SubikshaJ/GroundLoopIssue/Techathon Presentation.pptx

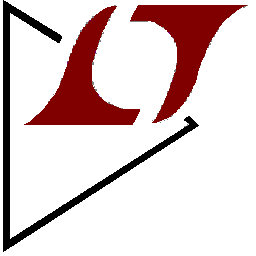
[picture p1: figure]
LTspice Download for Windows 11 PC. 64 bit

IEEE Techathon
Frequency Gate

Team: Ground Loop Issue
Noah Schunck
Subi Jayakumar
Mihir Chaudhari

## Slide 2

Problem

Audio effect pedals can make music sound better, but their frequency response is not ideal

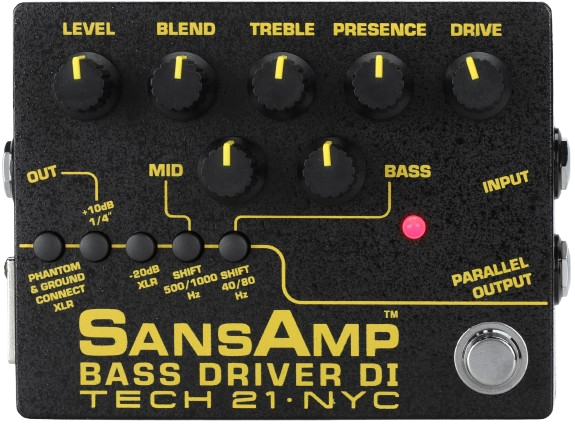
[picture p2: figure]

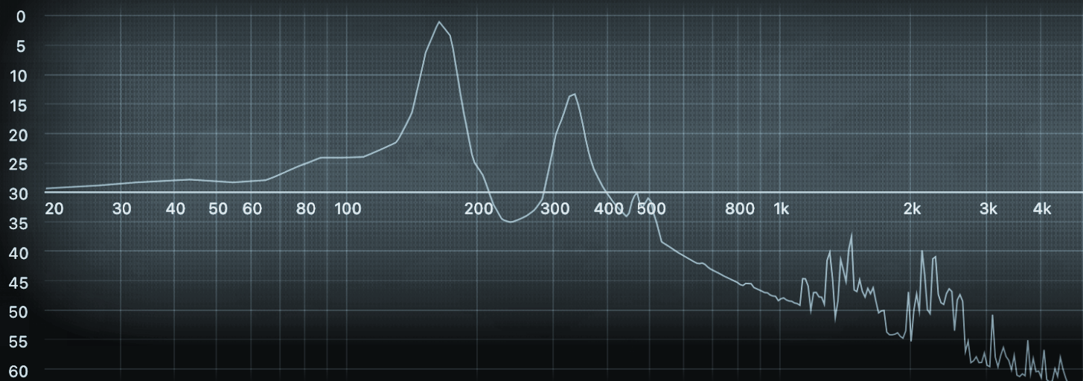
[picture p3: figure]

Frequency (Hz)

Unwanted frequency

## Slide 3

Non-ideal Frequency Response

E1 (Low note) + Effect

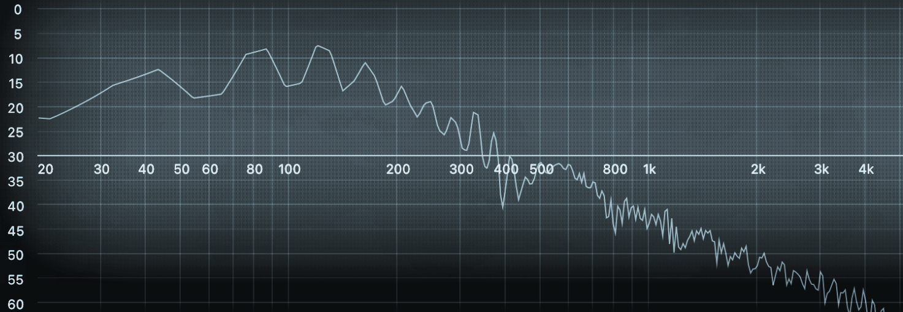
[picture p4: figure]

E3 (High note) + Effect

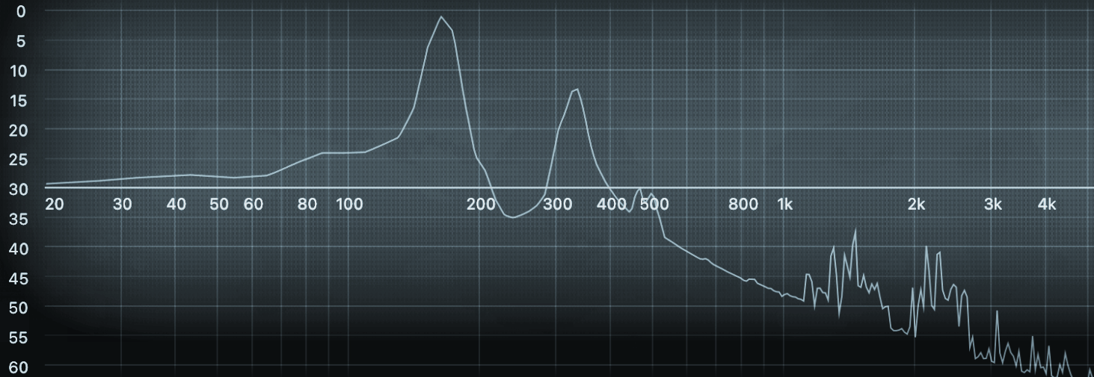
[picture p5: figure]

High frequency peaking, bad

Good

E1 (Low note) + No effect

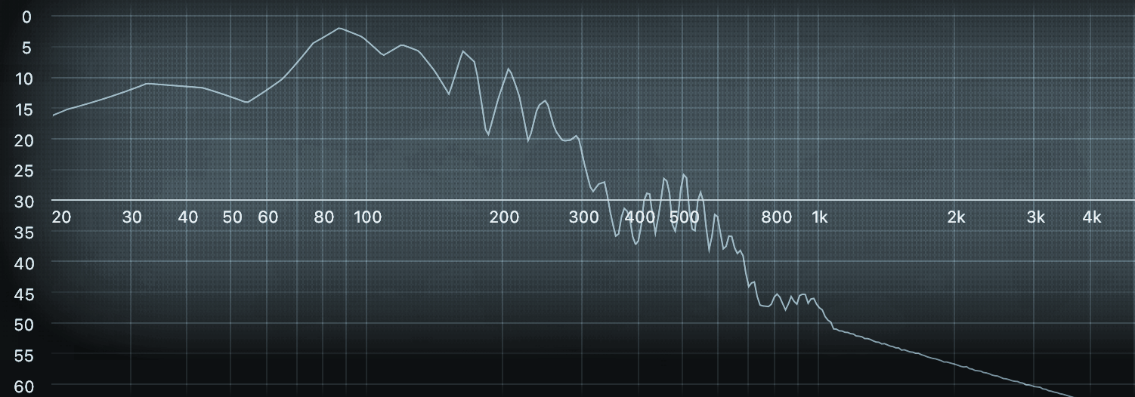
[picture p6: figure]

Lacks high frequency effects

E3 (High note) + No effect

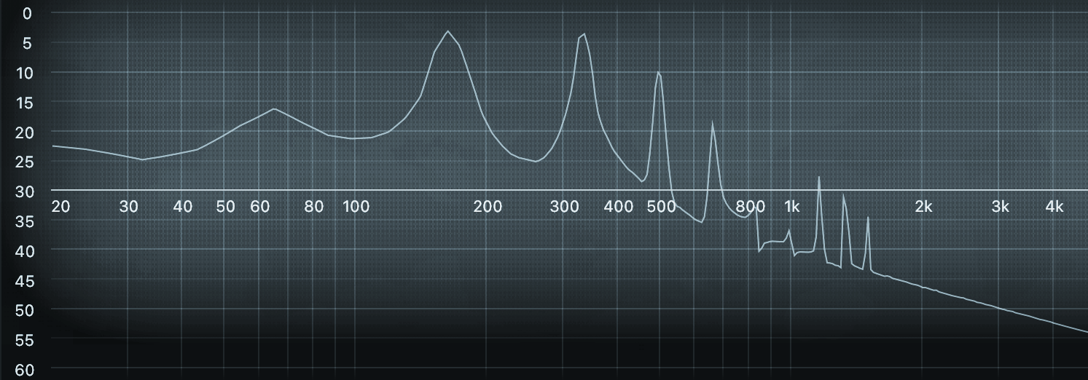
[picture p7: figure]

Good

Notes: Subi:
Audio Spectrums with an effect & without (direct)
Effect- Low: Desirable Effect, High: Noise & Unwanted peaking the higher frequencies
Direct Signal - Low: lacks harmonics & other high frequency effects wanted, High: Desirable outcome

## Slide 4

Demand for Frequency Based Effects

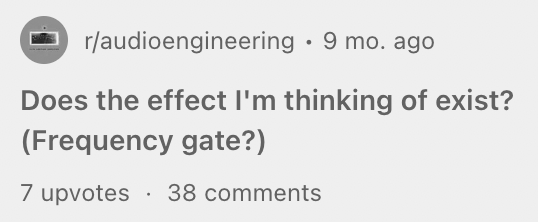
[picture p8: figure]
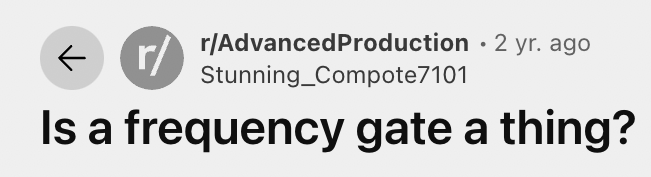
[picture p9: figure]
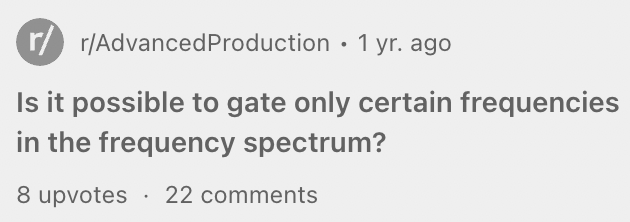
[picture p10: figure]

Notes: Subi: There is an unfulfilled need for an audio processing unit that activates an effect when only certain frequencies of notes are played.

## Slide 5

Solution

Frequency Gate: automatically toggles audio channels based on the frequency content of a signal

Bypass

Frequency Gate

Low
Notes

Input Signal

High
Notes

Notes: Subi

## Slide 6

Block Diagram

Guitar In

Buffer

Filter

Gain

Level Detection

Microcontroller

Ctrl

Buffer Out

Ch 1

Mixer

Effect
Clean

Pedal

Amp Out

Ch 2

*I/O Ports
*Internal Stages

Channel Select

## Slide 7

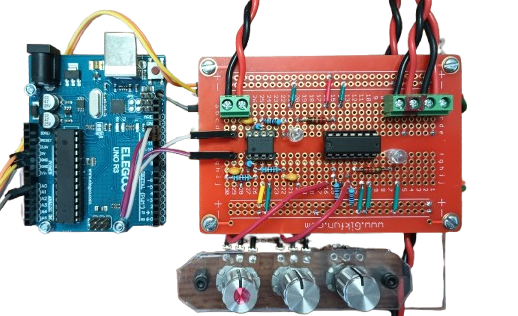
[picture p11: figure]

Physical Implementation

Amp OUT

Buffer OUT

Ch 1 & 2

Mixers

Gain

Guitar IN

## Slide 8

Power stage

Gain stage

Schematic

21 resistors
11 capacitors
6 TL072 op amps
1 CMOS switch IC

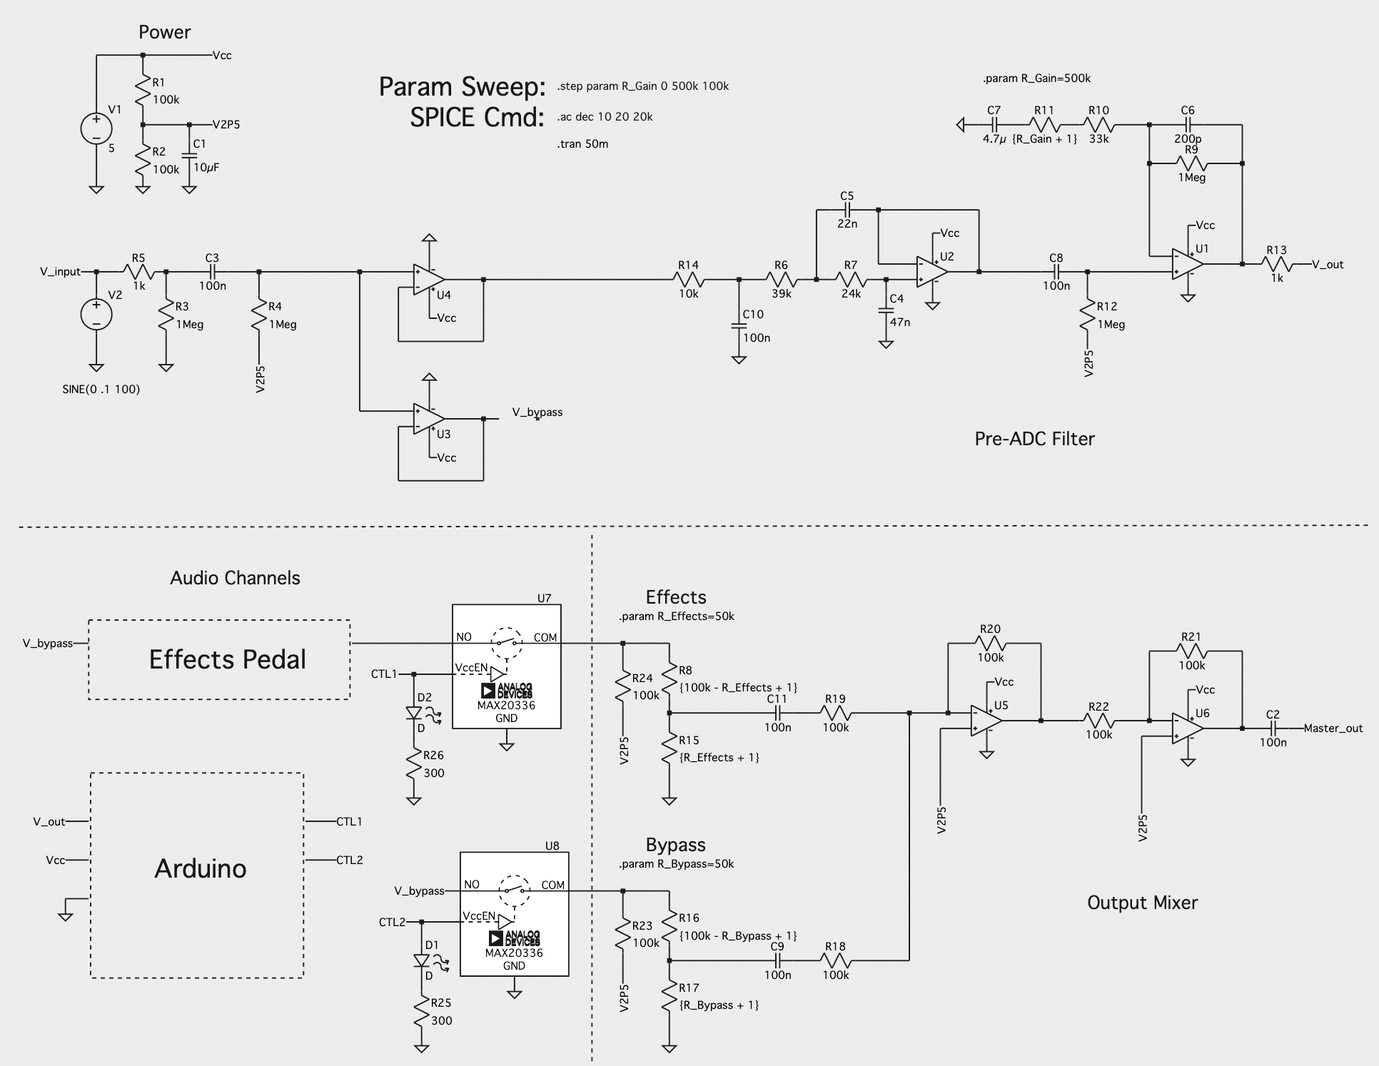
[picture p12: figure]

Buffer

Filter

Impedance Matching

Switches

Level shifters

Summing Amp

Output Buffer

## Slide 9

Demo

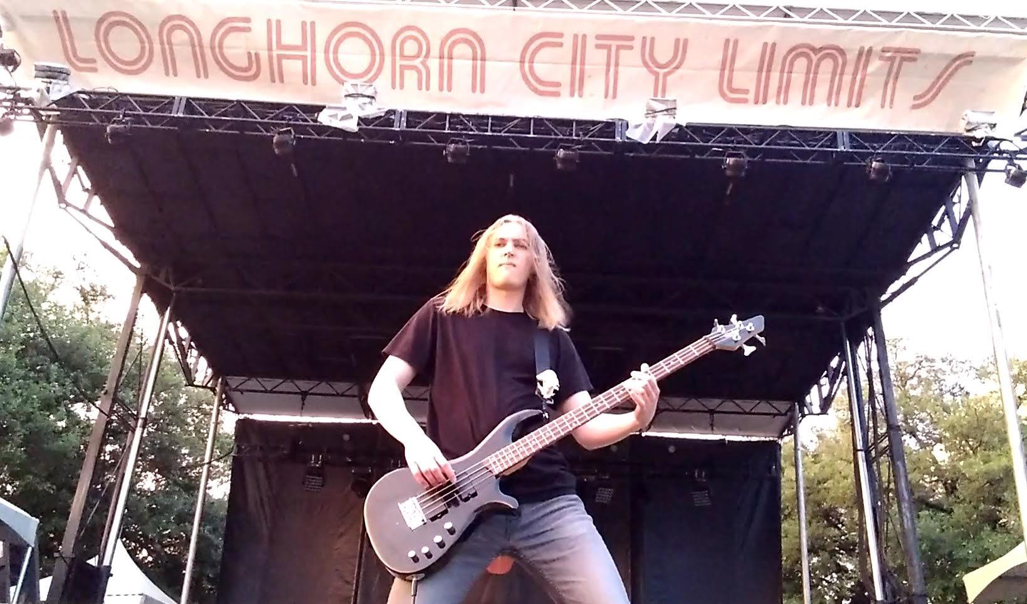
[picture p13: figure]

## Frequency Gate

Frequency Gate

Low
Notes

Bypass

Input Signal

High
Notes

## Slide 11

Low Notes

Want the harmonic content at higher frequencies

E1 (41Hz)
SansAmp

Good

E1 (41Hz)
Direct Signal

Bad

## Slide 12

High Notes

Do not want the effect at higher frequencies

E3 (164Hz)
SansAmp

Bad

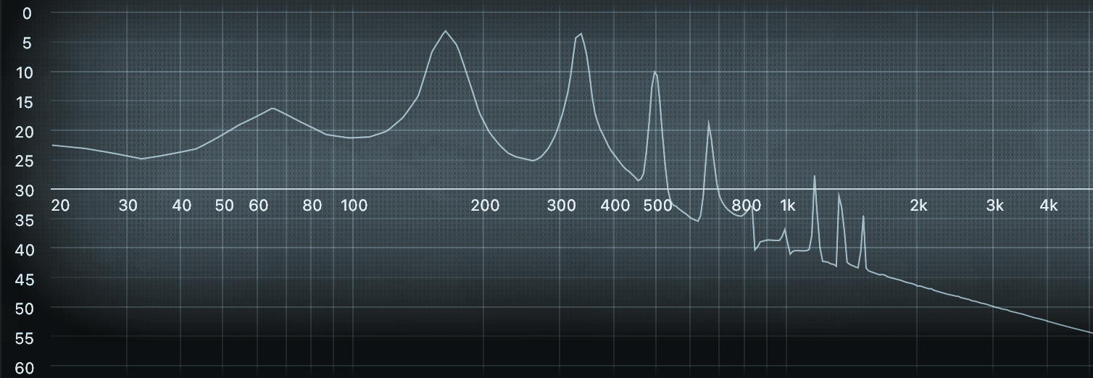
[picture p14: figure]

E3 (164Hz)
Direct Signal

Good

## Slide 13

Mixer Pot Performance

Tuning the mixer pot will change the amplitude of the signal

Pot: 10%

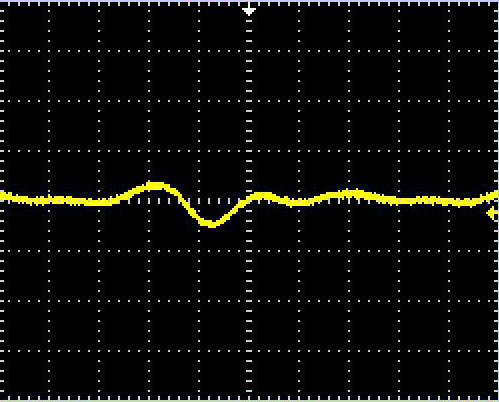
[picture p15: figure]

Vpp: 88 mV

Pot: 50%

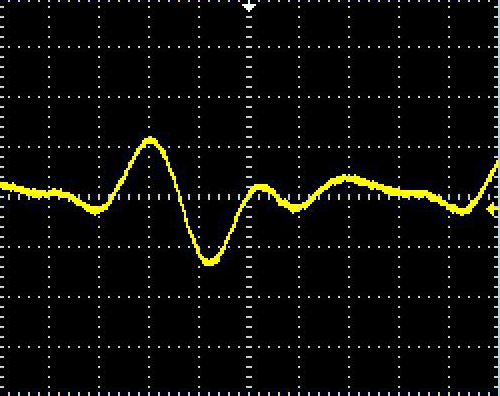
[picture p16: figure]

Pot: 100%

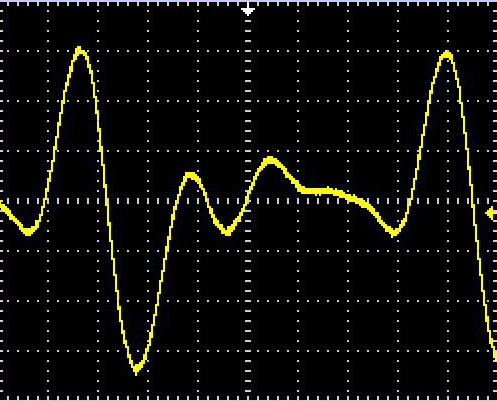
[picture p17: figure]

Vpp: 656 mV

Vpp: 256 mV

Test Note: A1 (55 Hz)

## Slide 14

Gain Pot Performance

Test Note: E1 (41 Hz)

Tuning the gain pot will change the amplitude of the output

Pot: 50%

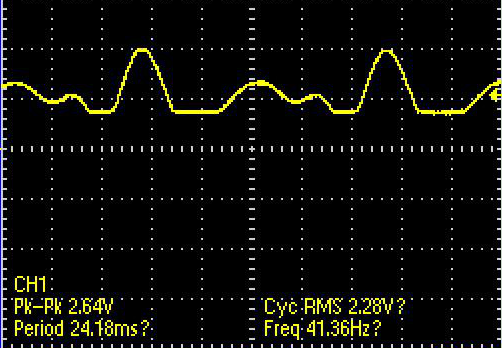
[picture p18: figure]

Pot: 100%

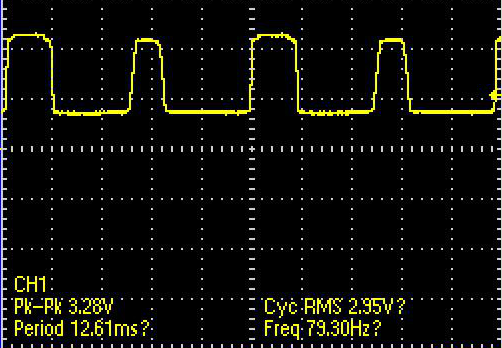
[picture p19: figure]

Max gain amplifies 1st harmonic to same level as fundamental

## Slide 15

Filter Performance

E1 (41 Hz)

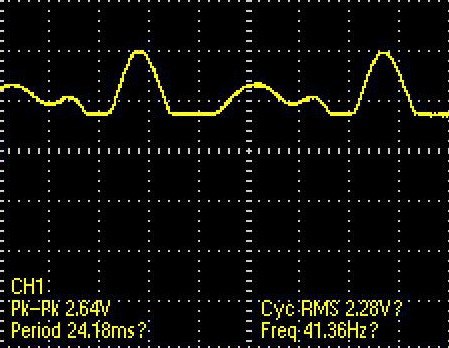
[picture p20: figure]

E2 (82 Hz)

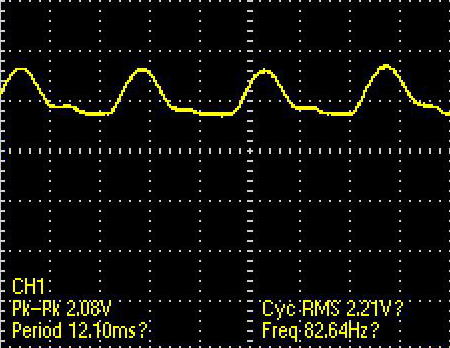
[picture p21: figure]

E3 (164 Hz)

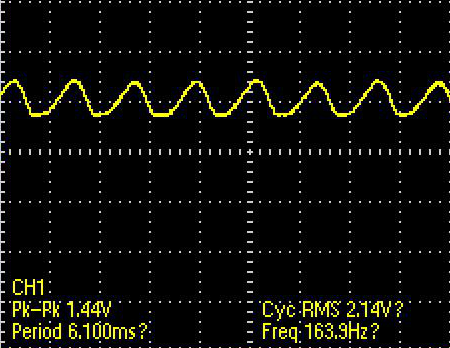
[picture p22: figure]

## Slide 16

Current Popular Solution: Vocoder

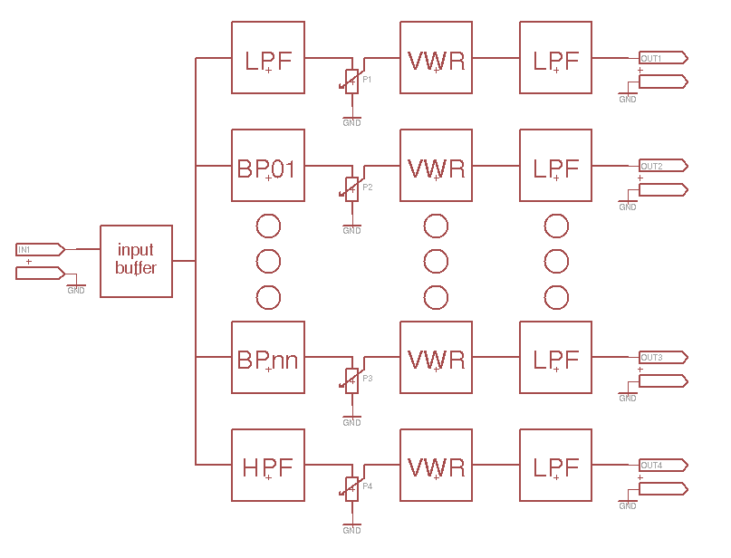
[picture p23: figure]
Vocoder Analyzer www.haraldswerk.de

1. Split signal into frequency bands
2. Process individual bands
3. Recombine frequency bands
