SubikshaJ/GroundLoopIssue/IEEE UT Techathon - Bill of Materials_GroundLoopIssue.pdf

# IEEE UT Techathon - Bill of Materials

Team Name:
Ground Loop Issue

Team Members:
Noah Schunck, Subi Jayakumar, Mihir Chaudhari

Product Name Purchased or received for free?

Where did your team get the product? (ex: TIW cabinets, eBay, etc.)

Cost:

Perfboards | Purchased | Amazon | 5.03
Screw Terminals | Purchased | Amazon | 0.75
TL072 op-amps | Purchased | Digikey | 3.30
CD4066 switch | Purchased | Digikey | 0.72
Potentiometer | Purchased | Digikey | 3.90
Capacitors | Free | Already owned | 0.00
Stand-offs | Free | Already owned | 0.00
Knobs | Free | Already owned | 0.00
Audio Jacks | Free | Already owned | 0.00

Final cost: 13.70
